cspwcspw/ESP32_Footswitches/Images/front_wiring.jpg

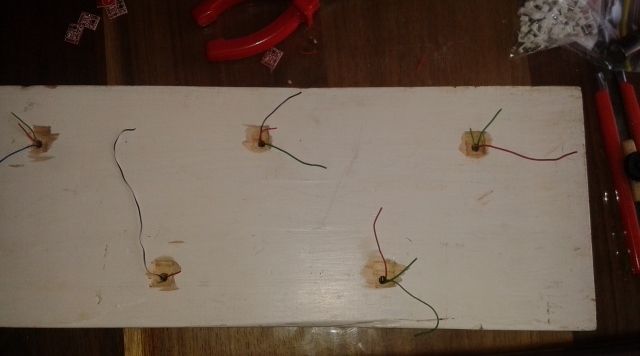
Images/front_wiring.jpg
